EzequielRodrigoPonce/Dosificadora-AccuFill-/README.md

<p align="center" width="100%">
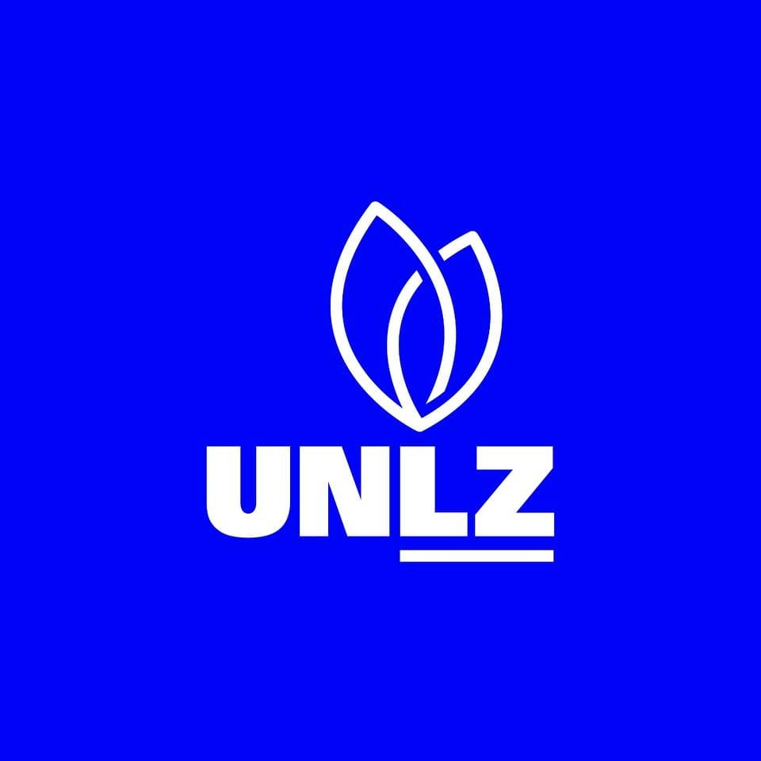
[picture p1: Readme.md/321138189_722314939154857_3310166726490044259_n.jpg]
    
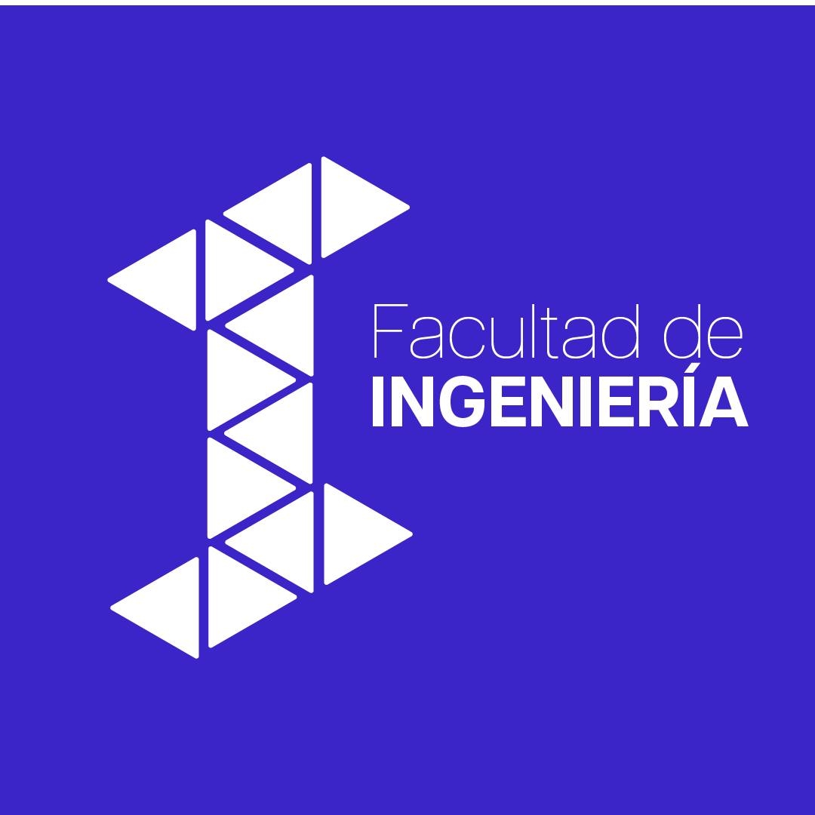
[picture p2: Readme.md/378230559_797453282383428_4968693939392363229_n.jpg]
    
</p>
<br><br><br>

<h1 align="center">Dosificadora Peristáltica</h1>
<br>
<br>
<h2 align="center">Integrantes:</h2>
<h3 align="center">Ponce, Rodrigo Ezequiel</h3>
<h3 align="center">Obermann, Cristian</h3>

 > **Tabla de Contenidos:**
 > - [Problema a Resolver](#item-uno)
 > - [Descripción](#item-dos)
 > - [Especificación de Requerimientos de la Dosificadora](#item-tres)
 > - [Proceso de Peristálsis](#item-cuatro)
>  - [Materiales Necesarios](#item-cinco)
>  - [Circuito Electrónico](#item-seis)
>  - [Programación](#item-siete)
>  - [Instrucciones de Uso](#item-ocho)
>  - [Construcción](#item-nueve)
>  - [Posibles Etapas Futuras a Desarrollar](#item-diez)

<br><br><br>

## Problema a Resolver:

Este proyecto se propone brindar una alternativa más barata, personalizable e intuitiva a la dosificación de líquidos para la industria alimenticia. En el mercado, este tipo de máquinas se pueden obtener una gran variedad de precios, caudales y precisión, pero su valor es muy alto en contraste con los componentes que forman el equipo, que pueden ser adquiridos por un precio relativamente bajo. Este proyecto además tiene como objetivo facilitar el uso mediante una interfaz de usuario amigable que se controle desde un Smartphone o una computadora.

## Descripción:

El proyecto consiste en desarrollar una solución económica y funcional para la dosificación de dos fluidos denominados componente “A” y componente “B” para obtener una preparación o distintas formulaciones que la industria alimenticia considere necesarias a partir de dos componentes.<br>
Se construirá un cubículo donde se concentran todos los componentes electrónicos y el espacio de dosificación que funcionará con un motor eléctrico y diversos sensores que harán al automatismo y control del proceso. Asimismo, se construirán dos bombas peristálticas encargadas de la dosificación.<br>
Se tendrá un espacio donde colocar un recipiente para ser leído por un sensor que permite que se aplique la cantidad programada de un determinado fluido “A” Y “B”, luego se tendrá la formulación deseada. <br>
Este prototipo está destinado a ser construido como modelo de prueba para la industria alimenticia, con un nivel de precisión y tolerancia acorde a dicha industria y etapa del proyecto.

## Especificación de Requerimientos de la Dosificadora

-    El usuario podrá especificar la cantidad de líquido y las proporciones del líquido A y B que se dosificarán mediante un servidor web, través de un Smartphone o computadora, siguiendo una dirección de internet ó escaneando un código QR, se podrá controlar con una interfaz intuitiva.<br>
-    Una vez especificadas las proporciones a dosificador, se deberá transportar un recipiente vacío sobre una plataforma que se encuentra dentro del equipo, en el punto donde se deposita el recipiente está tendrá un sensor óptico capaz de detectar su presencia, esto hará que la plataforma traslade el recipiente y se detenga debajo de la manguera a la salida de la bomba peristáltica.<br>
-    Los dos recipientes que contienen los líquidos A y B estarán encima de balanzas de precisión. Estas ayudaran a mejorar la precisión con la que se distribuyen los líquidos.<br>
-    Las bombas peristálticas serán capaces de distribuir líquido dentro de un rango de caudal de 100 a 1500 mL/min.    

## Proceso de Peristálsis:
Las [bombas peristálticas](https://en.wikipedia.org/wiki/Peristaltic_pump "Wikipedia") funcionan cuando los rodillos comprimen la manguera al girar, creando un vacío que succiona fluido a través de esta. En este tipo de bomba, solo la manguera de elastómero flexible entra en contacto con el fluido, eliminando el riesgo de que la bomba contamine el fluido o a la inversa.<br>
En la Imagen se puede observar el fluido entrando en la manguera de la bomba, atrapado por el rodillo del cabezal de bombeo, y expulsado cuando el próximo rodillo pasa sobre la manguera. Al girar los rodillos, se forma un vacío en la manguera, succionando más fluido, para el próximo paso del rodillo.<br>
El cierre total de la manguera al ser comprimida entre el rodillo y la pista (oclusión) proporciona a la bomba una acción de desplazamiento positivo, evitando el reflujo y eliminando la necesidad de válvulas reguladoras cuando la bomba no está en funcionamiento.

<p align="center" width="100%">
    
</p>

## Materiales Necesarios: 

| Componente | Cantidad | Precio [US$] |
|---|:---:|:---:|
| ESP32 | x2 | 22
| MOTOR NEMA 17 | x2| 60.5
| DRIVER DRV8825 | x2| 6.6
| CELDA DE CARGA HX711 | x2| 14
| PLACA EXPERIMENTAL | x1| 3.15 
| PACK DE CABLES | x1| 3.83
| RODAMIENTOS 684Zz | x12| 8.5
| TUBO GRADO ALIMENTICIO | x2| 6.8
| SENSOR ULTRASONICO | x1| 1.64
| SENSOR INFRARROJO| x2| 6.58
| FILAMENTO PLA| x1| 8.22
| TORN. + ARANDELAS M4| x12| 1
| EXTRAS (CABLES, TRAFOS, ESTAÑO, ETC.)| x1| 13.7
| DISPLAY LCD 20X4| x1| 7.8
| FUENTE DE ALIMENTACIóN 12V| x1| 11
| TOTAL| | US$ 175.32

## Circuito Electrónico:  

En la electrónica se investigaron y se utilizaron los siguientes componentes:<br>
<br>**NEMA 17 y DRV8825**: Motor PaP y su controlador utilizado en la bomba para dosificar líquidos.
<br>**MOTOR DC**: Utilizado para girar la plataforma que rotará el recipiente debajo del pico dosificador
<br>**SENSOR IR**: Utilizado para detectar la presencia del recipiente vacío en la plataforma y debajo del pico dosificador.
<br>**MICRO SWITCH**: Utilizado en la puerta de la dosificadora para interrumpir todos los procesos en caso de que esta se abra.
<br>**CELDA DE CARGA Y HX711**: Utilizada para pesar constantemente la cantidad de líquido en los tanques contenedores.
<br>**DISPLAY LCD**: Utilizado para mostrar la dirección web de la dosificadora y las cantidades a dosificar.
<br>**ESP32**: Se utilizaron dos, uno que contiene las celdas de carga y el LCD, y otra que contiene todo lo demás, se dividieron en dos ESP32 por las incompatibilidades que existen entre las celdas de carga y los NEMA 17 si se usan al mismo tiempo. Para soluciones estos problemas de compatibilidad se consultó al profesor de Fundamentos de los Computadores Digitales de la UNLZ.
<br>**FUENTE DE COMPUTADORA**: Se utilizó para alimentar toda la dosificadora. Se consultó al profesor de Electrónica la UNLZ, la forma de calcular el voltaje y amperaje necesario de la fuente a utilizar. 
<br>
<br>

 ### **ESP32 con Motores** 
<br>
<p align="center" width="100%">
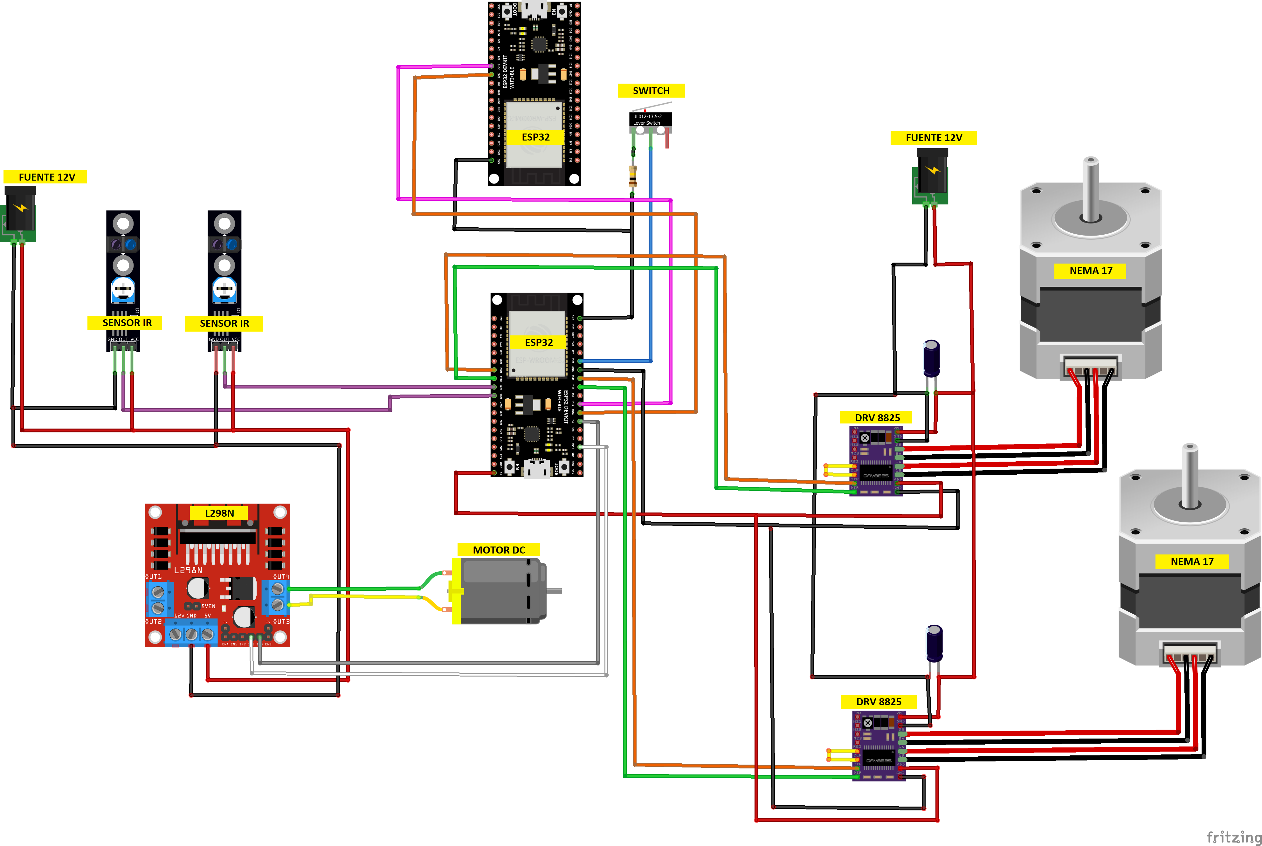
[picture p3: Circuito de Dosificadora/Circuito de ESP con Motores.png]
    
</p>
<br>

### **ESP32 con Celdas de Carga**
<br>
<p align="center" width="100%">
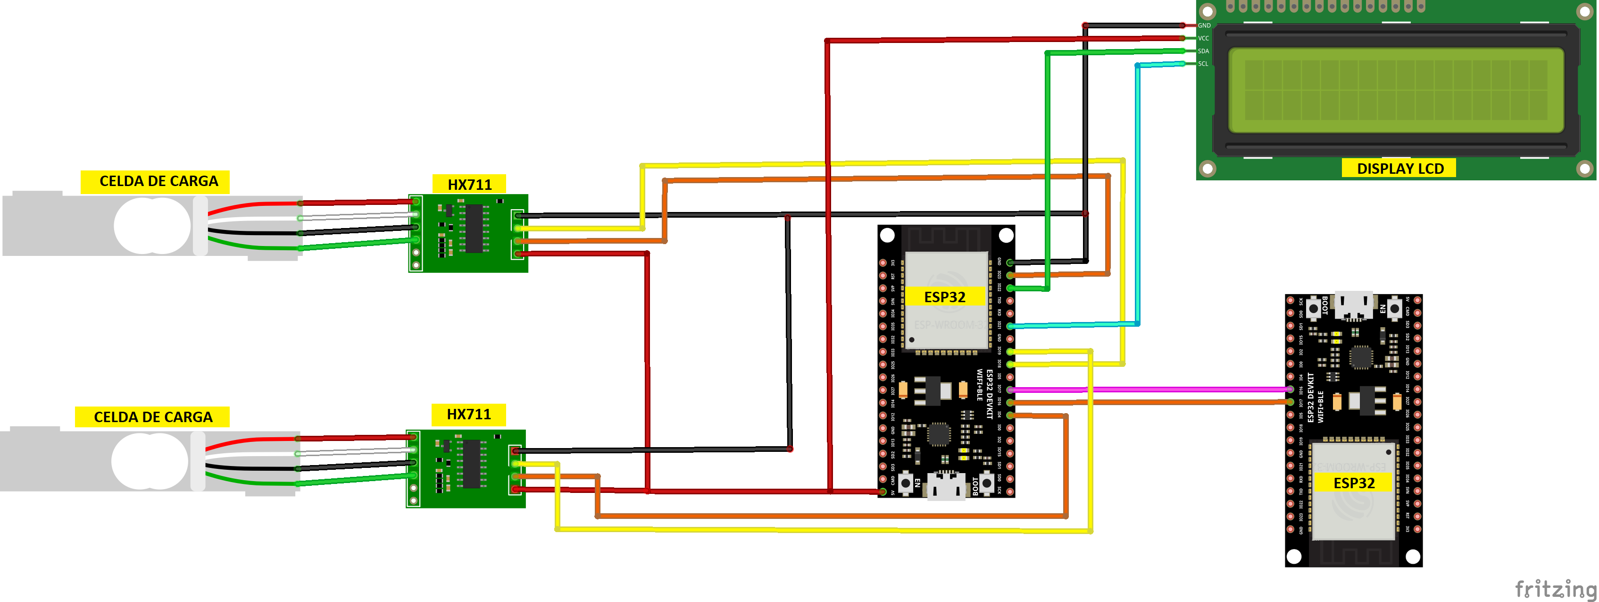
[picture p4: Circuito de Dosificadora/Circuito de ESP32 Con Pag Web.png]
    
</p>
<br>

 ## Programación:
Programación 
En la programación de los dos ESP32, se tuvieron que dividir los códigos.<br>
-    El código de un ESP32 se encargaba de controlar los dos NEMA 17 para la dosificación, los sensores infrarrojos para la detección del recipiente donde se depositará el líquido dosificado, el motor de CC para la plataforma giratoria y un micro switch para la puerta de la dosificadora.<br>
-    El otro código se encarga de las celdas de cargas que pesan constantemente los recipientes contenedores de líquido para dosificar y un display LCD que muestra un mensaje de bienvenida y los parámetros de dosificación que se ingresaron. <br>
-    Para lograr la comunicación entre los dos ESP32 se utiliza la comunicación serial con los pines RX y TX. Además solo se envían pocos datos por el serial porque si se envían constantemente se ralentiza el ESP32 con los NEMA 17, por serial solo se envían avisos de que se ingresaron los valores a dosificar por la página web y cuando la celda de carga ya detectó que se dosifico ese valor ingresado.

 ## Instrucciones de Uso:
<br>
<p align="center" width="100%">
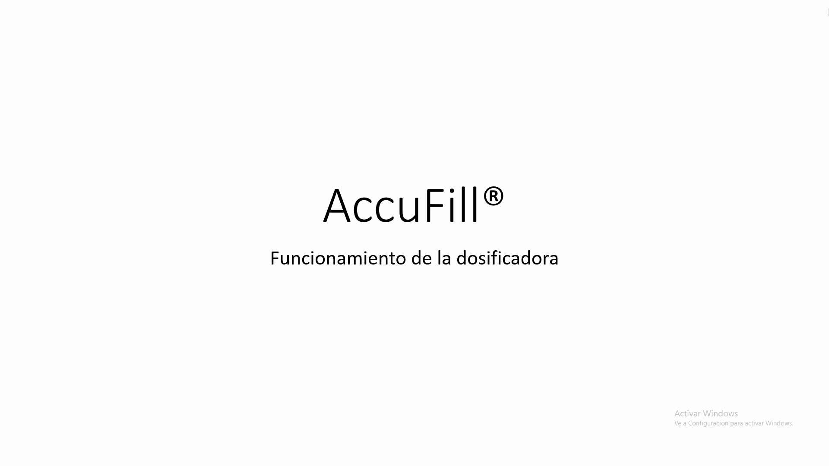
[picture p5: Readme.md/GIF Parte 1.gif]
    
</p>
<br>
<br>
<br>

<p align="center" width="100%">
    
</p>

<br>
<br>
<br>
<p align="center" width="100%">
    
</p>

## Construcción:
 Para todos los componentes impresos en 3D, la electrónica y su cableado se hizo una estructura para alojar todo. Esta está hecha de madera, placa de acrílico para las partes visibles y partes impresa en 3D para las bisagras y los soportes de los acrílicos. 

<table align="center" style="margin-left: auto; margin-right: auto;">
<tr>
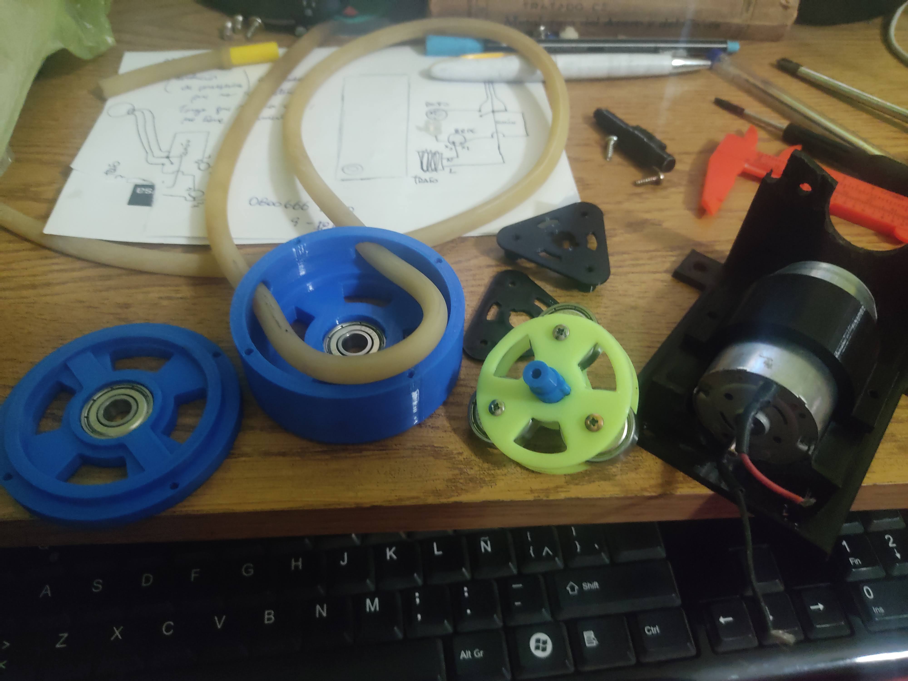
[picture p6: Imagenes/Ensamblando bomba.jpg]
<td> <br>Ensamblaje de Bomba </td>
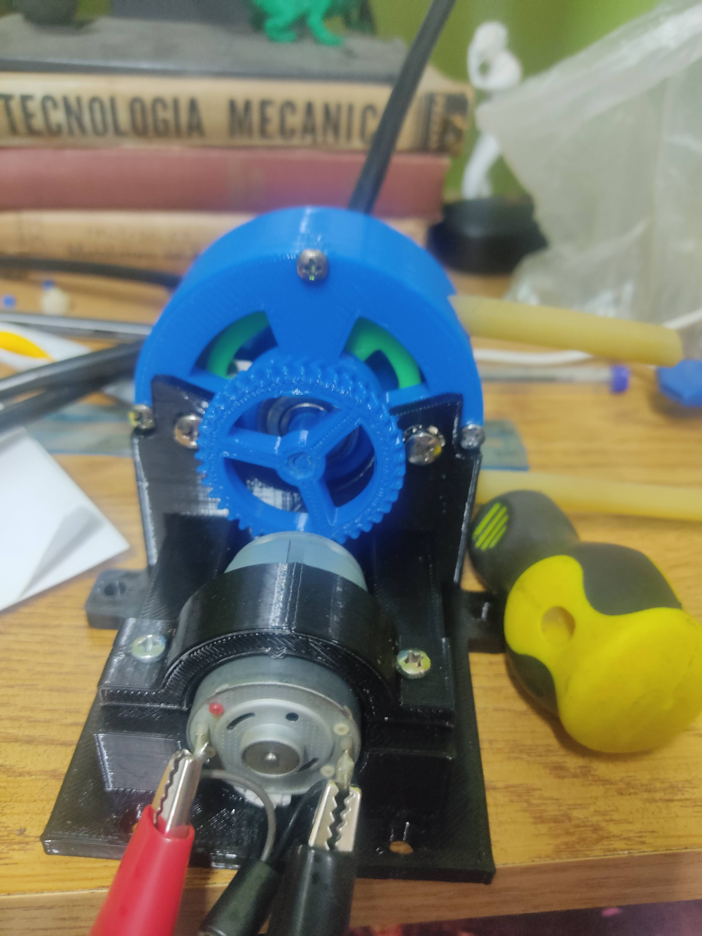
[picture p7: Imagenes/Probando bomba con el primer motor CC.jpg]
<td> <br>Testeo </td>
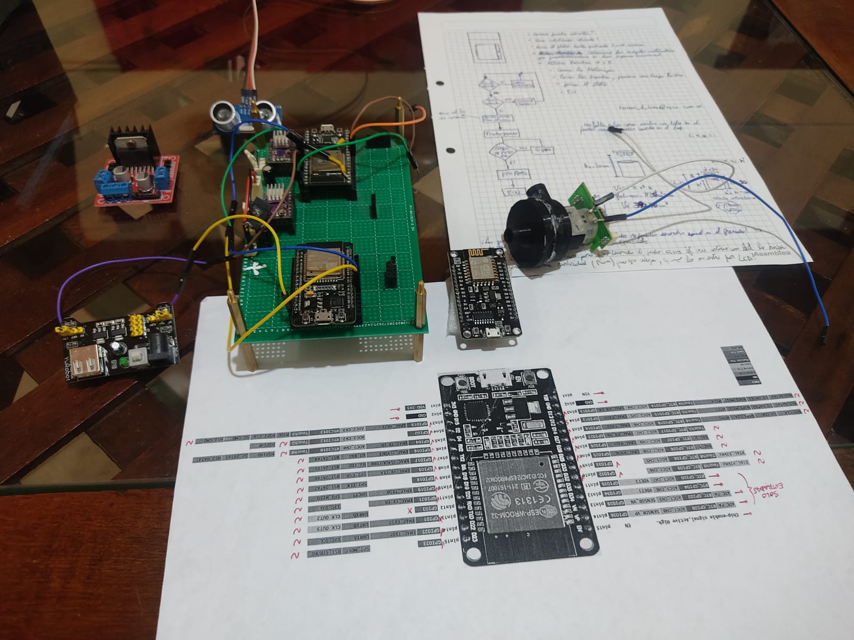
[picture p8: Imagenes/Revisión de pines.jpg]
<td> <br>Cableado de Circuito </td>
</tr>
<tr>
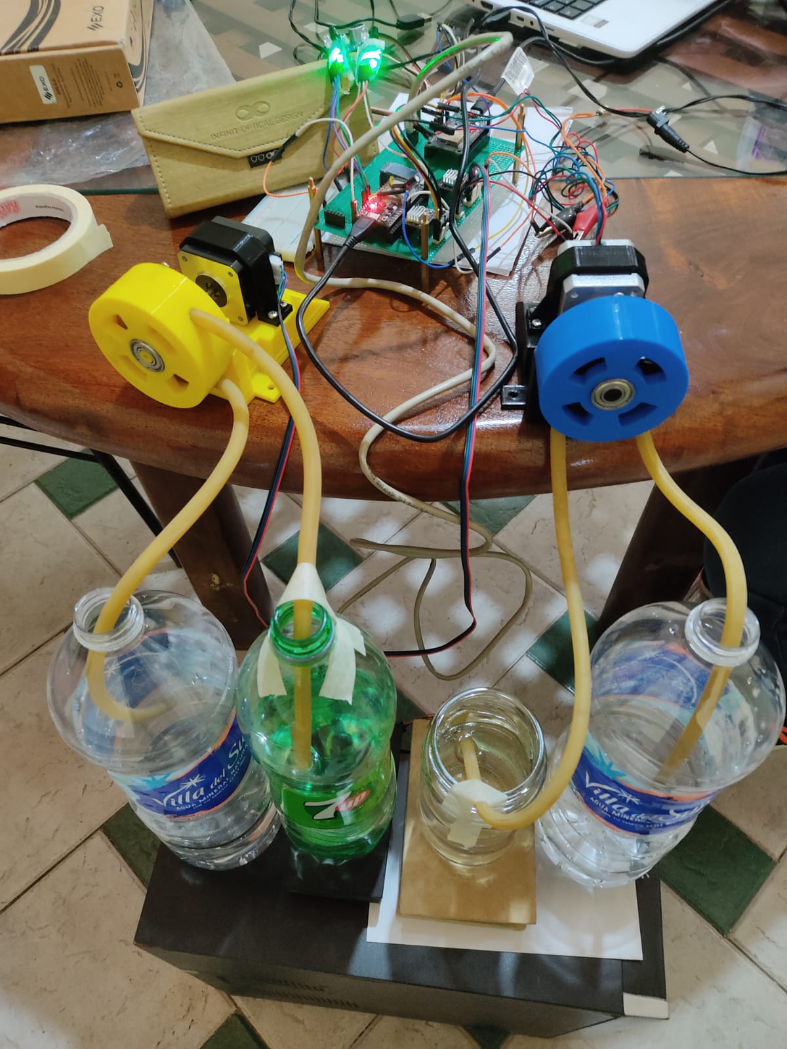
[picture p9: Imagenes/Imagen de WhatsApp 2023-12-01 a las 23.33.35_a418374a.jpg]
<td> <br>Calibración </td>
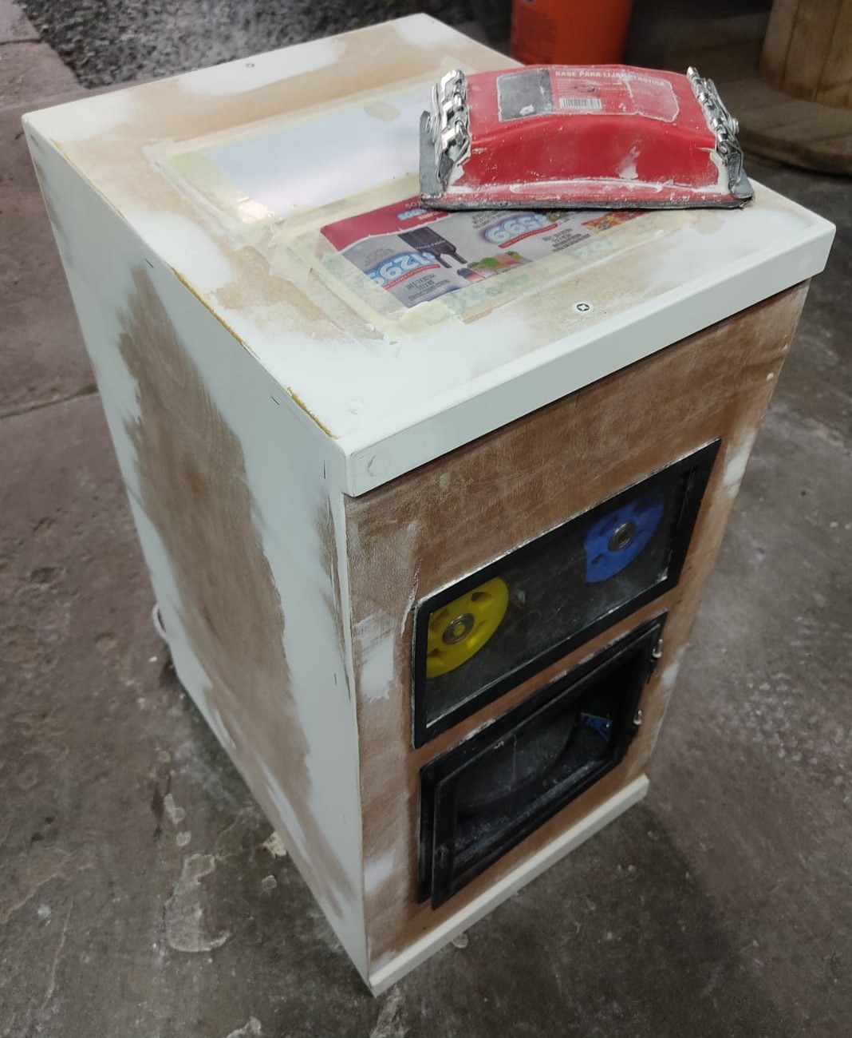
[picture p10: Imagenes/Preparativos para la estructura.jpg]
<td> <br>Lijado de Dosificadora </td>
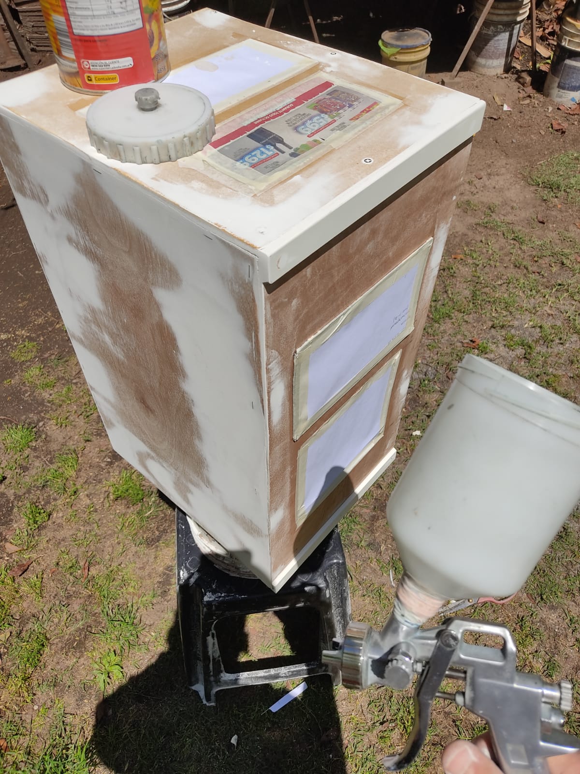
[picture p11: Imagenes/Pintando la estructura del prototipo.jpg]
<td> <br>Pintado de Dosificadora </td>
</tr>
<tr>
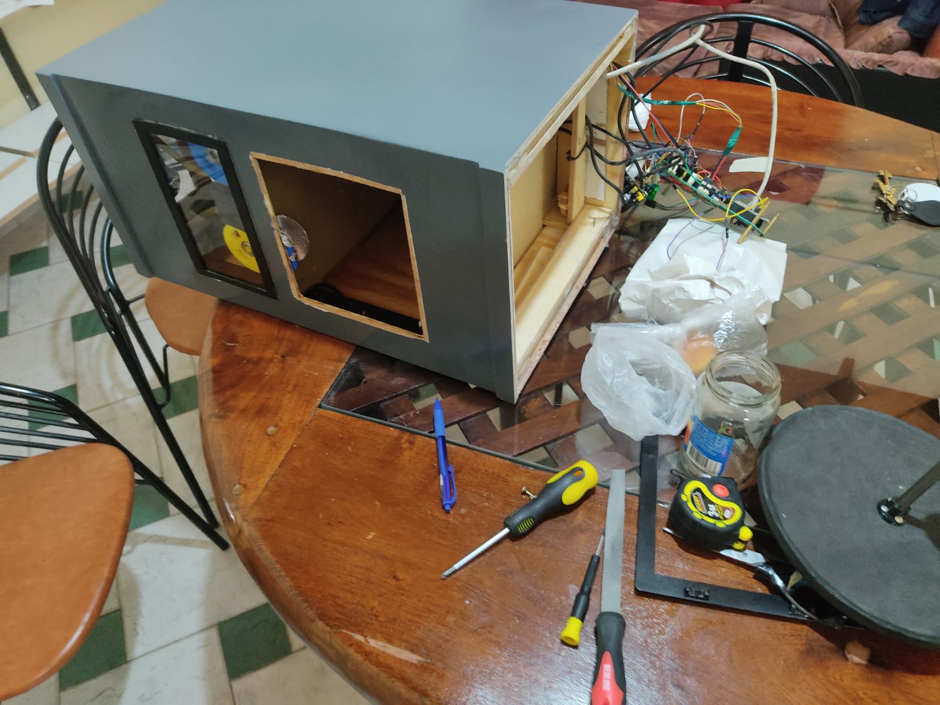
[picture p12: Imagenes/distribución y montaje de cables en la base.jpg]
<td> <br>Armado Final </td>
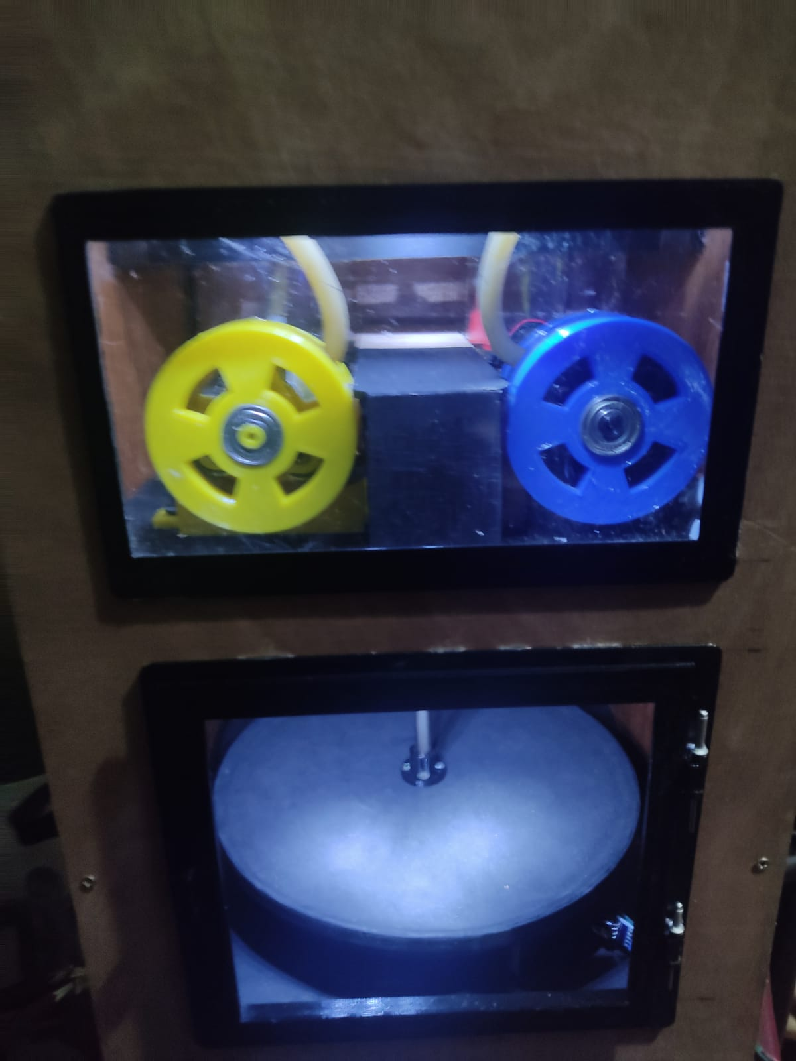
[picture p13: Imagenes/colocación de luces en cabina de dosificación y bombas.jpg]
<td> <br>Vista Frontal  </td>
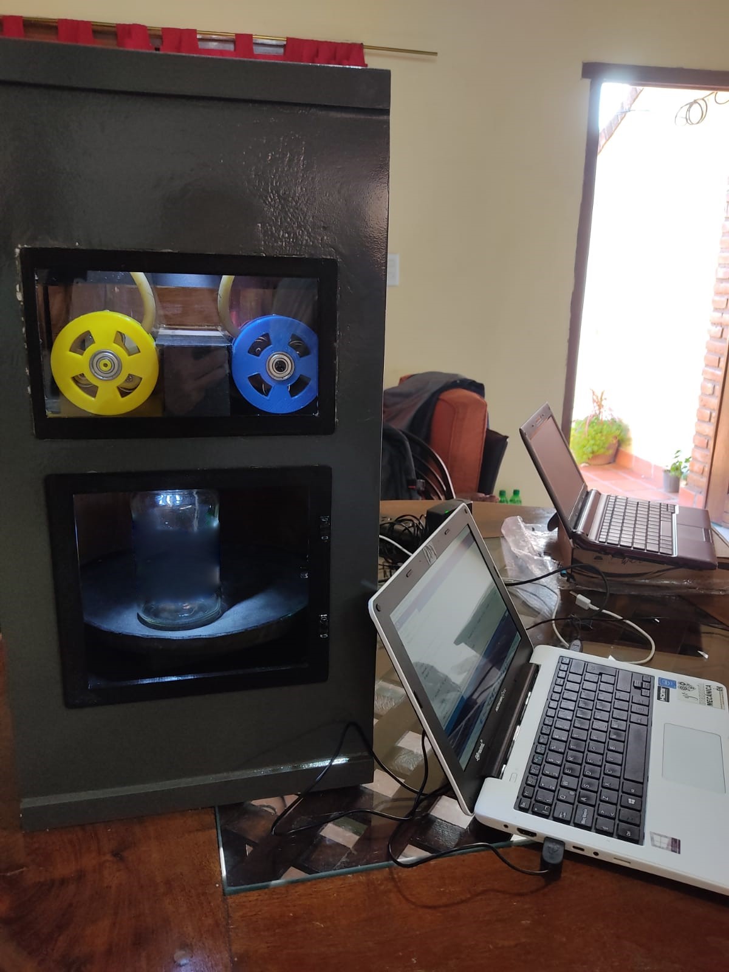
[picture p14: Imagenes/Probando comunicación serial entre pagina y motores.jpg]
<td> <br>¡Dosificadora Completada! </td>
</tr>
</table>
<br>
<br>
<br>

## Posibles Etapas Futuras a Desarrollar:

Una etapa posible sería encontrar una forma de poder comparar los datos recibidos de la balanza y la cantidad de pasos del nema 17 al dosificar para aumentar la precisión del líquido dispensado.
Para poder obtener valores confiables que relacionen la cantidad de pasos del nema 17 con la cantidad de líquido dosificado es necesario modificar el diseño de la bomba peristáltica, porque la manguera tiene demasiado juego entre la carcasa impresa y el rodamiento que la aprieta, debido a esto no se logra formar un vacío que impida que cuando se detengan los motores los líquidos retrocedan de vuelta al recipiente expendedor.<br>
Otra etapa sería aumentar la velocidad de dosificación de la bomba manteniendo la estabilidad del dispositivo o agregar más bombas a la dosificadora para permitir múltiples dosificaciones independientes entre sí, esto hará que el proyecto sea más rentable y útil en aplicaciones de la industria.<br>
En el siguiente video se muestra una dosificadora multi-canal:

<p align="center" width="100%">
  <a href="https://www.youtube.com/watch?v=ZArngSEx4A0" title="Dosificadora Multi Canal">
    Dosificadora Multi Canal
  </a>
    
</p>
