EzequielRodrigoPonce/Dosificadora-AccuFill-/Imagenes/pagina web1.png

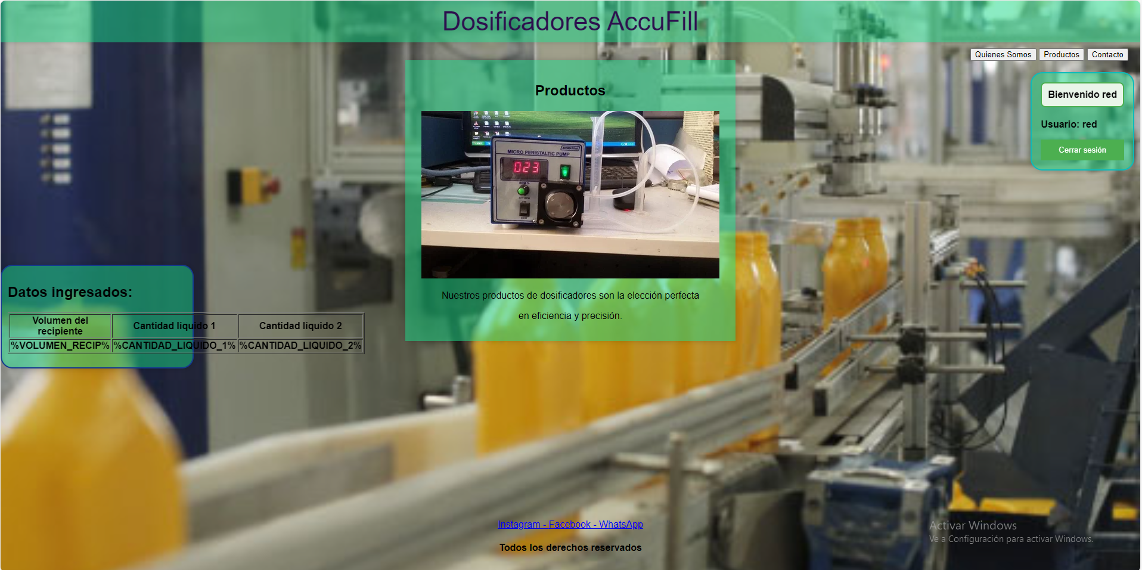
Imagenes/pagina web1.png
