EzequielRodrigoPonce/Dosificadora-AccuFill-/Imagenes/pagina web2.png

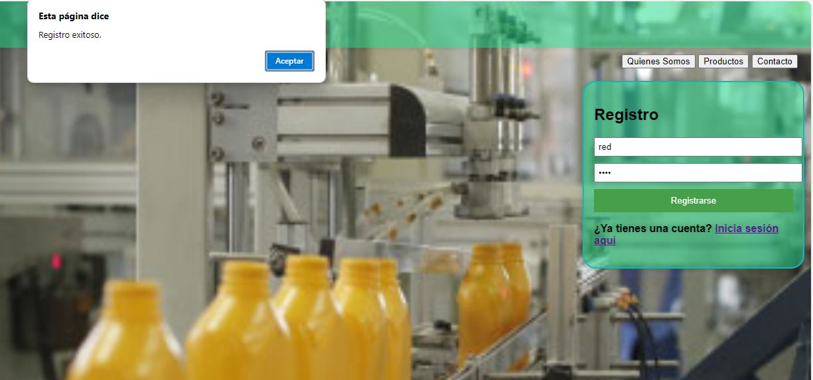
Imagenes/pagina web2.png
