EzequielRodrigoPonce/Dosificadora-AccuFill-/Imagenes/pagina web inicio de sesion.png

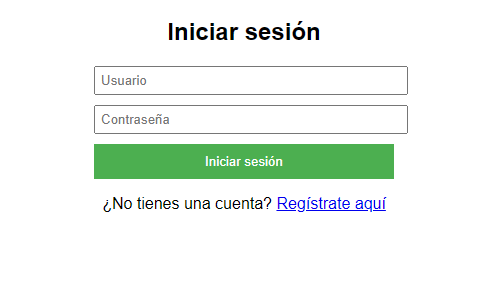
Imagenes/pagina web inicio de sesion.png
