EzequielRodrigoPonce/Dosificadora-AccuFill-/Readme.md/Captura de pantalla 2024-05-21 185250.png

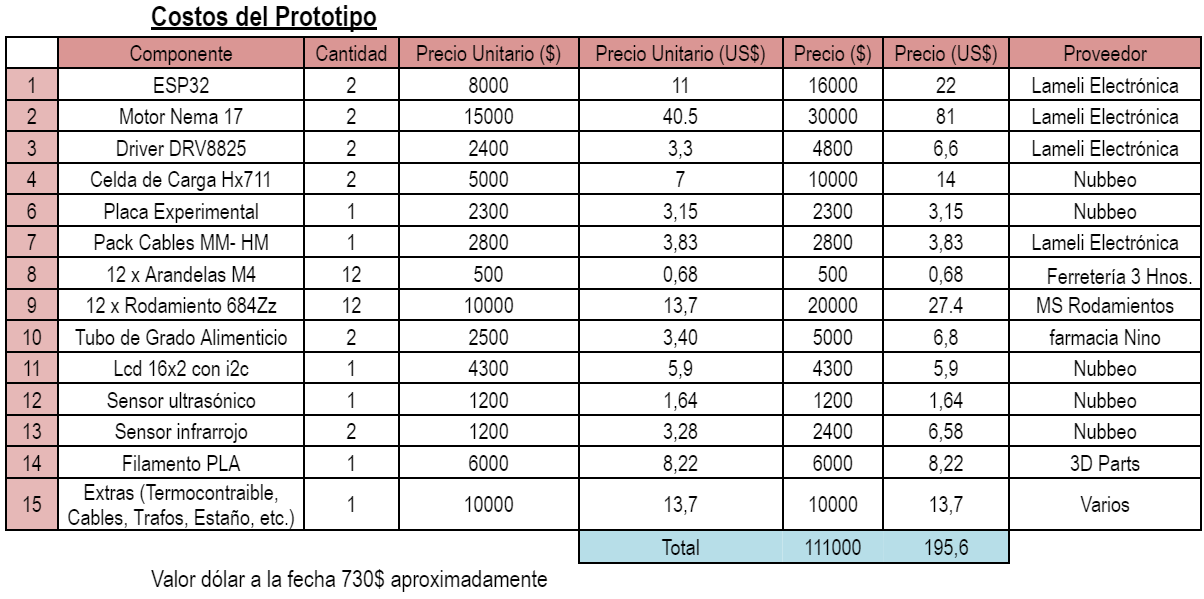
Readme.md/Captura de pantalla 2024-05-21 185250.png
