EzequielRodrigoPonce/Dosificadora-AccuFill-/Readme.md/GIF Parte 3.gif

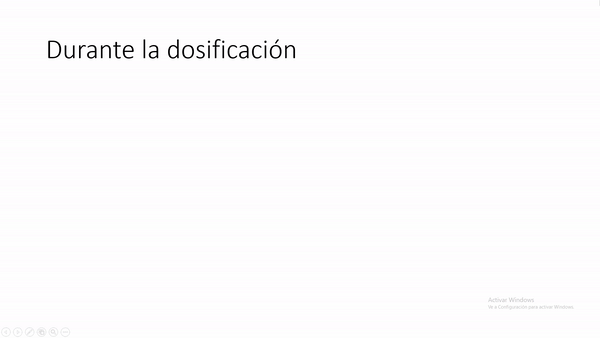
Readme.md/GIF Parte 3.gif
