EzequielRodrigoPonce/Dosificadora-AccuFill-/Imagenes/montaje estético maqueta.jpg

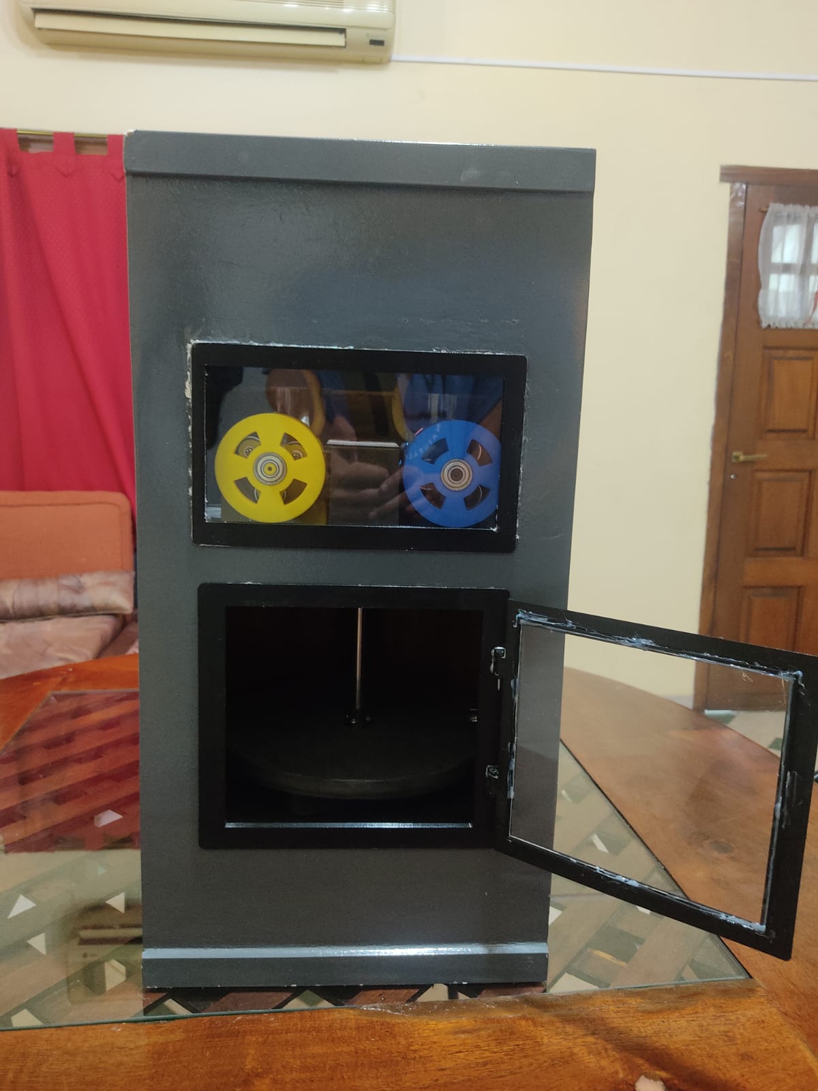
Imagenes/montaje estético maqueta.jpg
