EzequielRodrigoPonce/Dosificadora-AccuFill-/Planos/Plano Bomba Peristaltica.pdf

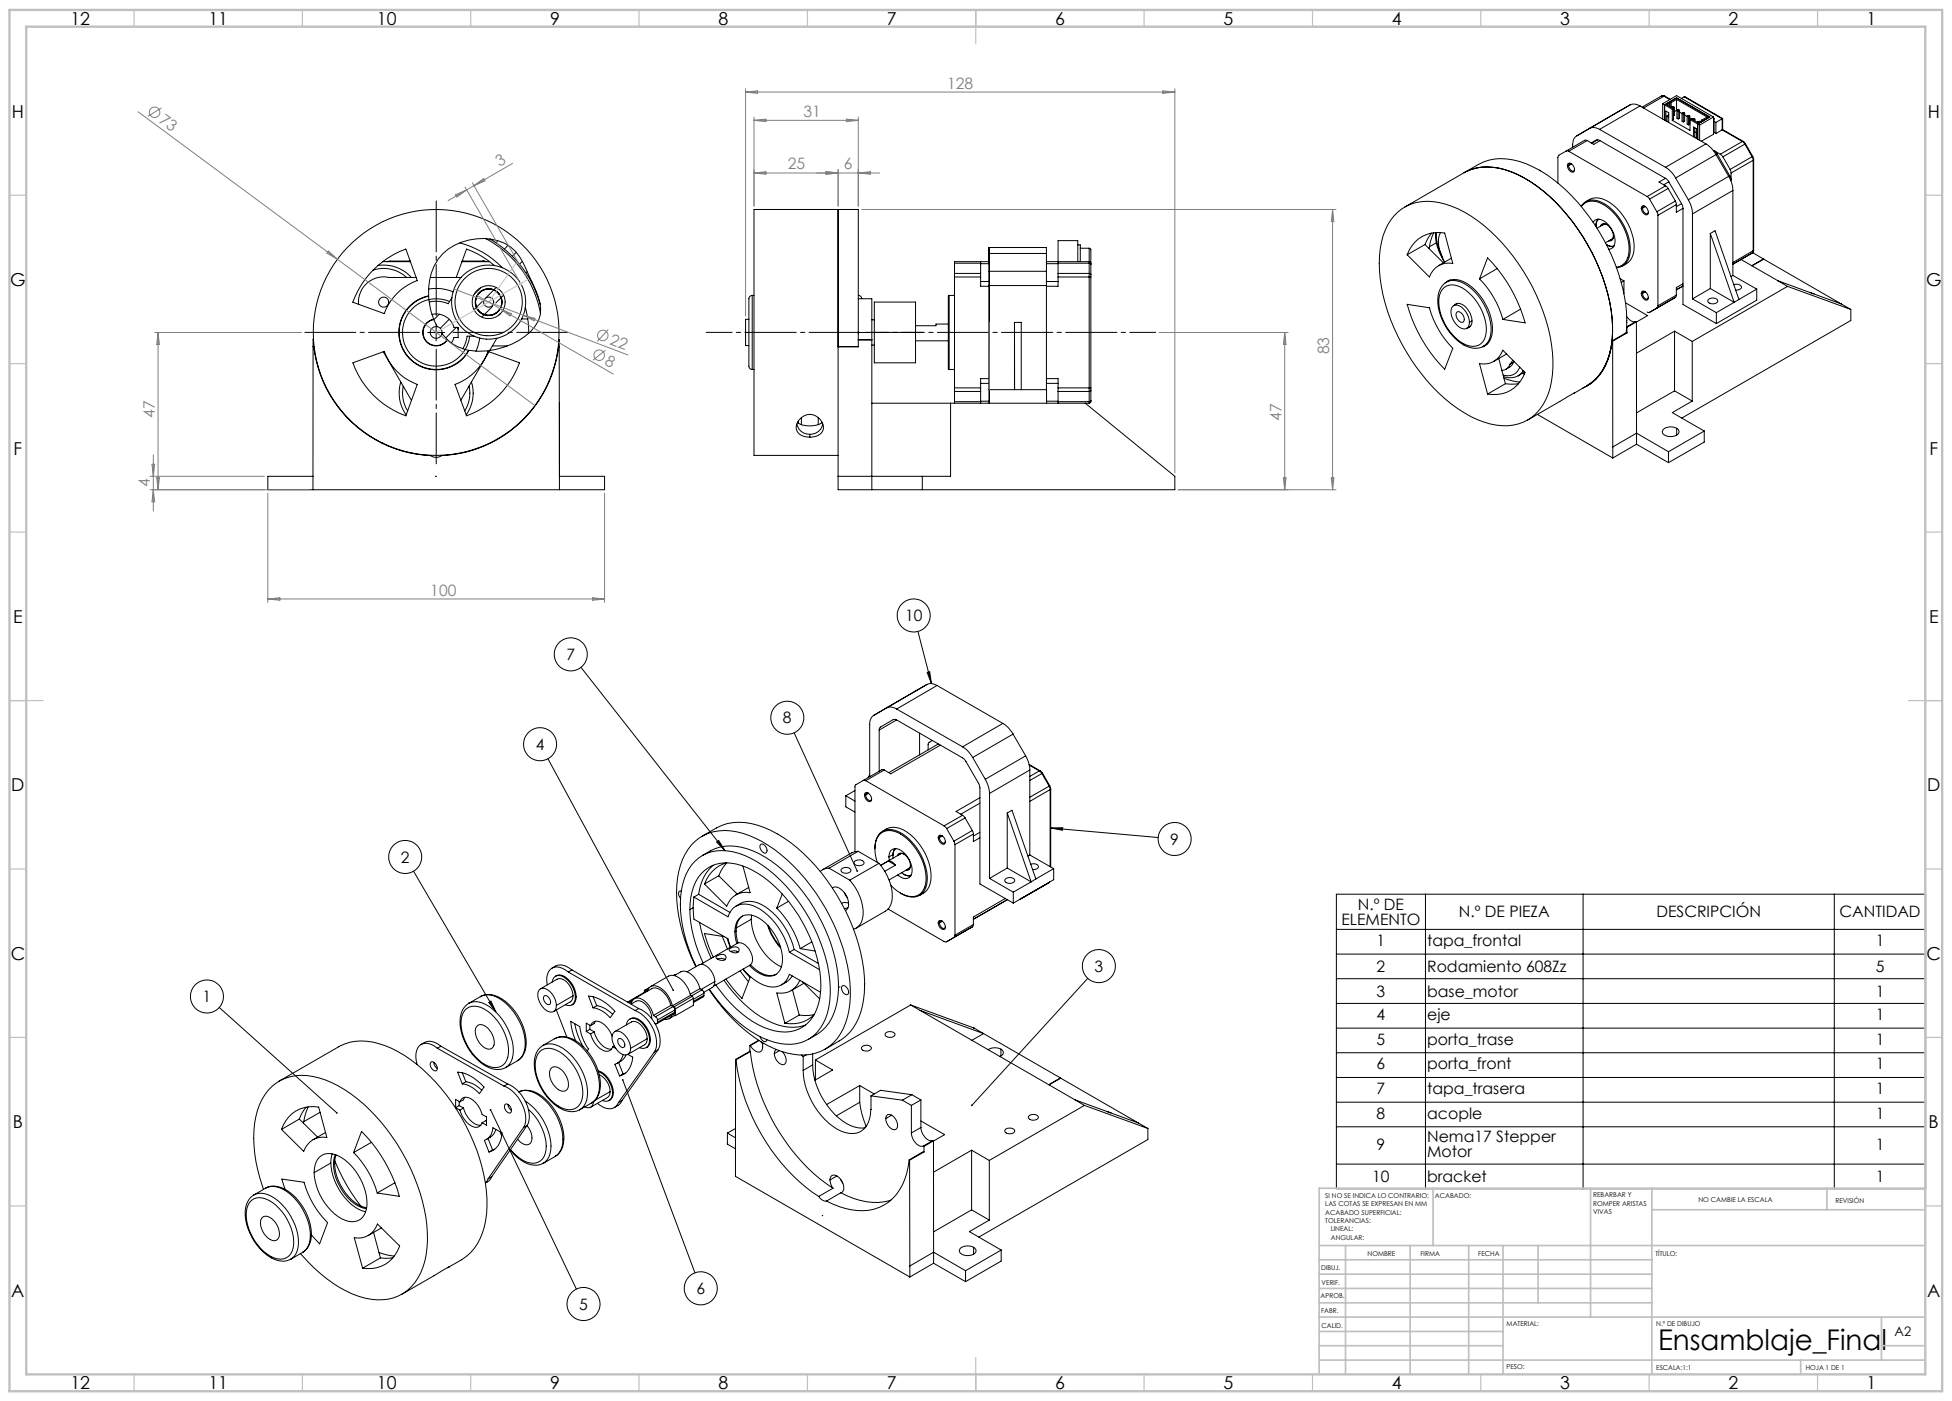
[picture p35: page 1]
ESCALA:1:1; HOJA 1 DE 1

N.º DE ELEMENTO | N.º DE PIEZA | DESCRIPCIÓN | CANTIDAD
1 | tapa_frontal | | 1
2 | Rodamiento 608Zz | | 5
3 | base_motor | | 1
4 | eje | | 1
5 | porta_trase | | 1
6 | porta_front | | 1
7 | tapa_trasera | | 1
8 | acople | | 1
9 | Nema17 Stepper Motor | | 1
10 | bracket | | 1

SI NO SE INDICA LO CONTRARIO: LAS COTAS SE EXPRESAN EN MM ACABADO SUPERFICIAL: TOLERANCIAS: LINEAL: ANGULAR: | ACABADO: | REBARBAR Y ROMPER ARISTAS VIVAS | NO CAMBIE LA ESCALA | REVISIÓN

NOMBRE | FIRMA | FECHA | | | | TÍTULO:

DIBUJ.
VERIF.
APROB.
FABR.
CALID. | | | | MATERIAL: | N.º DE DIBUJO Ensamblaje_Final | A2
