EzequielRodrigoPonce/Dosificadora-AccuFill-/Planos/Plano Dosificadora.pdf

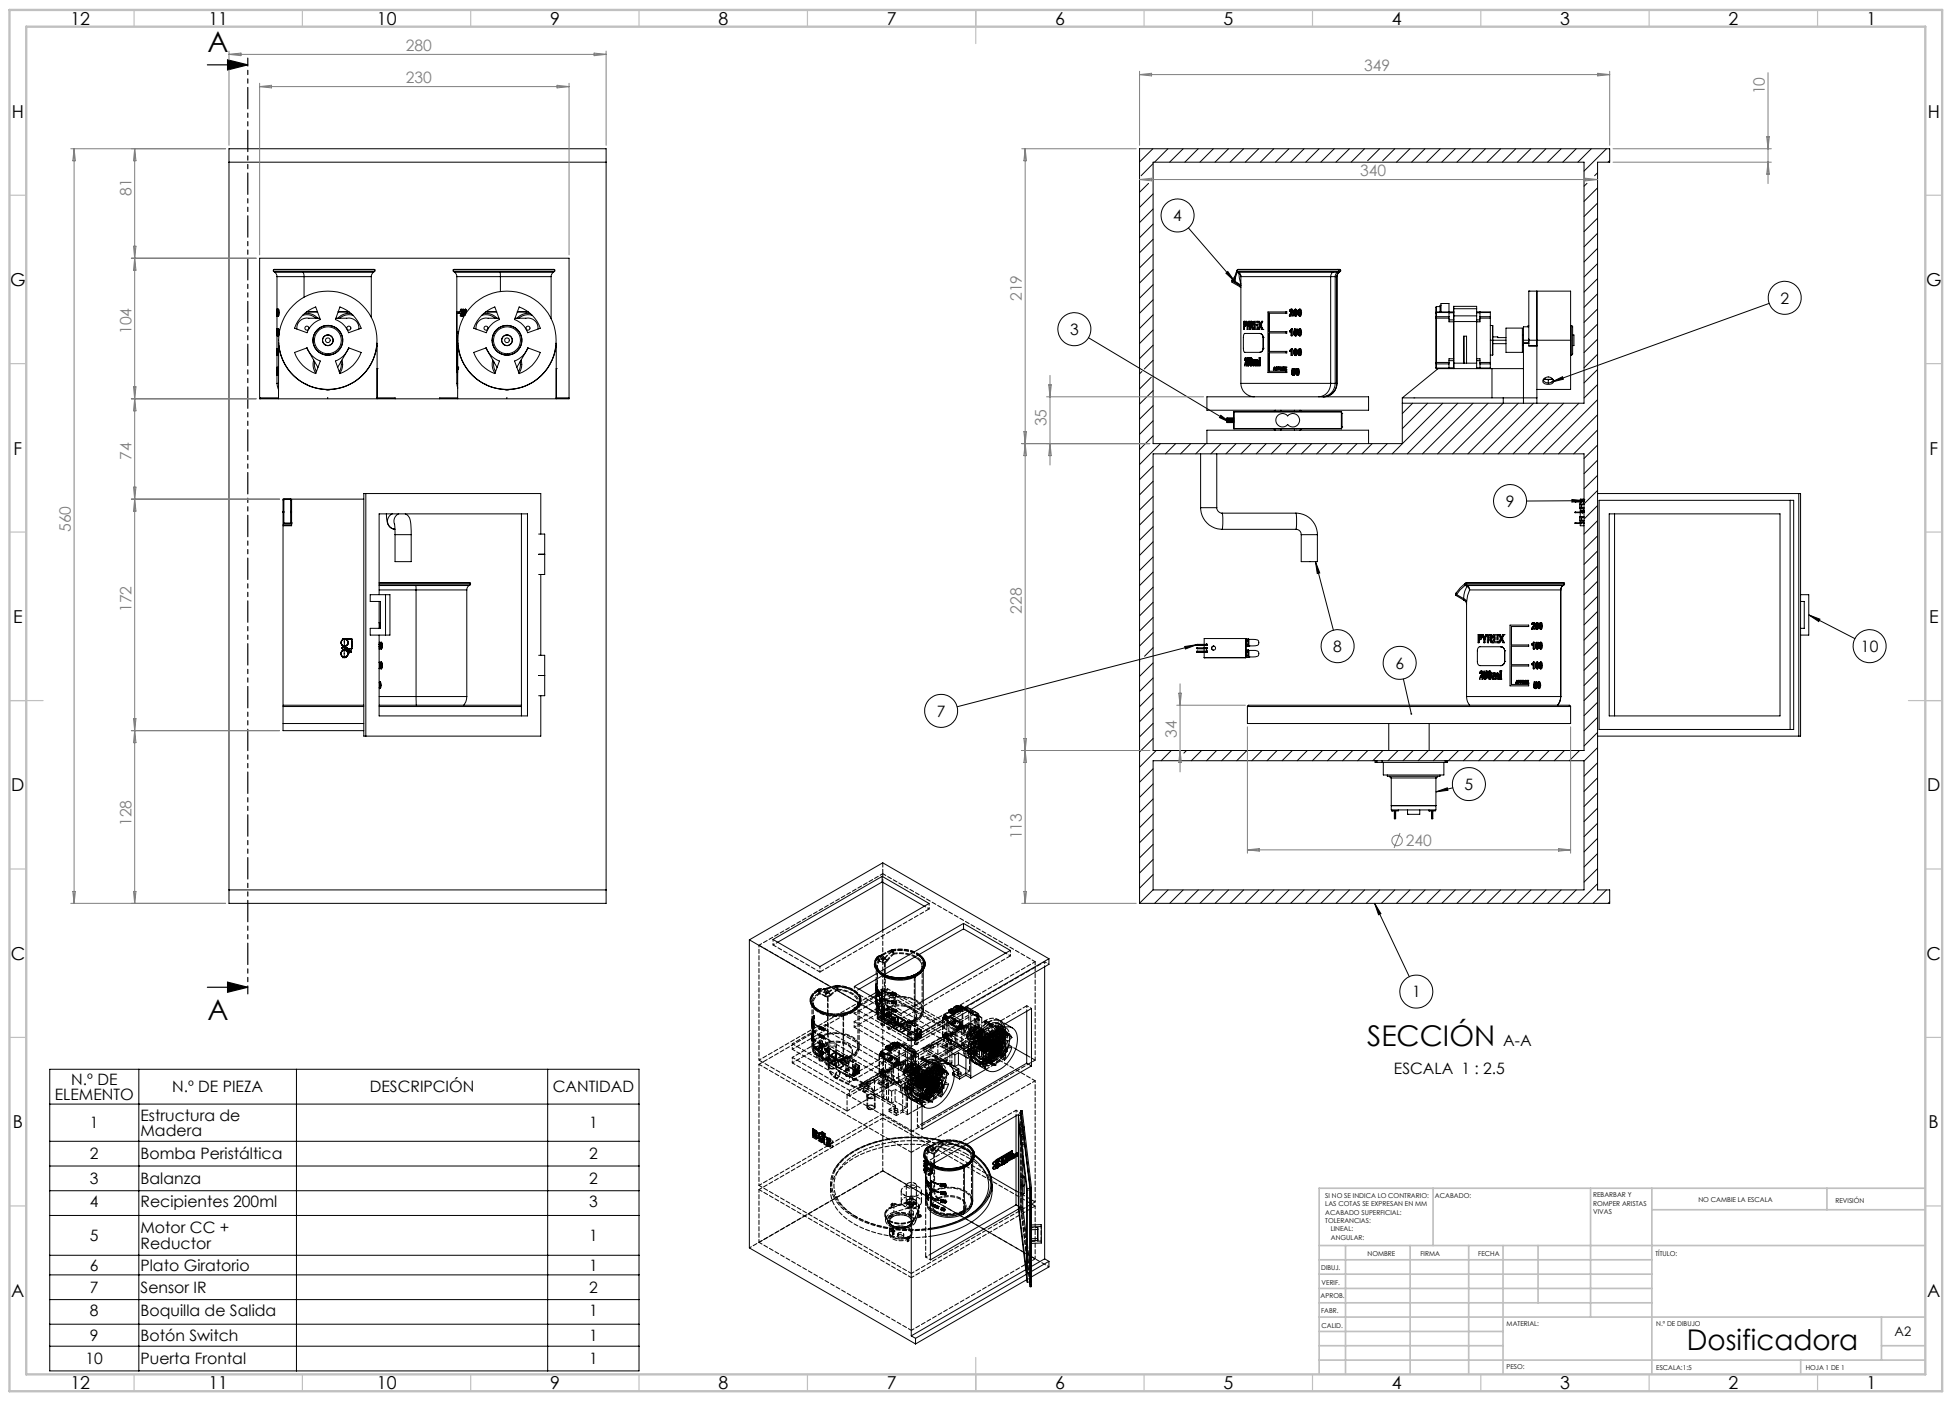
[picture p36: page 1]
SECCIÓN A-A; ESCALA 1 : 2.5; ELEMENTO; N.º DE PIEZA; DESCRIPCIÓN; CANTIDAD 1; Estructura de; Bomba Peristáltica; Recipientes 200ml; Motor CC +; Plato Giratorio; Sensor IR; Boquilla de Salida; Botón Switch; Puerta Frontal; ACABADO:; REBARBAR Y; ROMPER ARISTAS; NO CAMBIE LA ESCALA; REVISIÓN; N.º DE DIBUJO; ESCALA:1:5; HOJA 1 DE 1

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
