EzequielRodrigoPonce/Dosificadora-AccuFill-/(commit log)

2024-04-04 Create Circuito de Dosificadora
2024-04-04 Rename Circuito de ESP con Motores.png to Circuito de Dosificadora/Circuito de ESP con Motores.png
2024-04-04 Rename Circuito de ESP32 Con Pag Web.png to Circuito de Dosificadora/Circuito de ESP32 Con Pag Web.png
2024-05-13 Add files via upload
    Archivo 3D de la dosificadora peristáltica
